TrevorFryman/BAE305-SP26-SemesterProject/Gear for servo Drawing v2.pdf

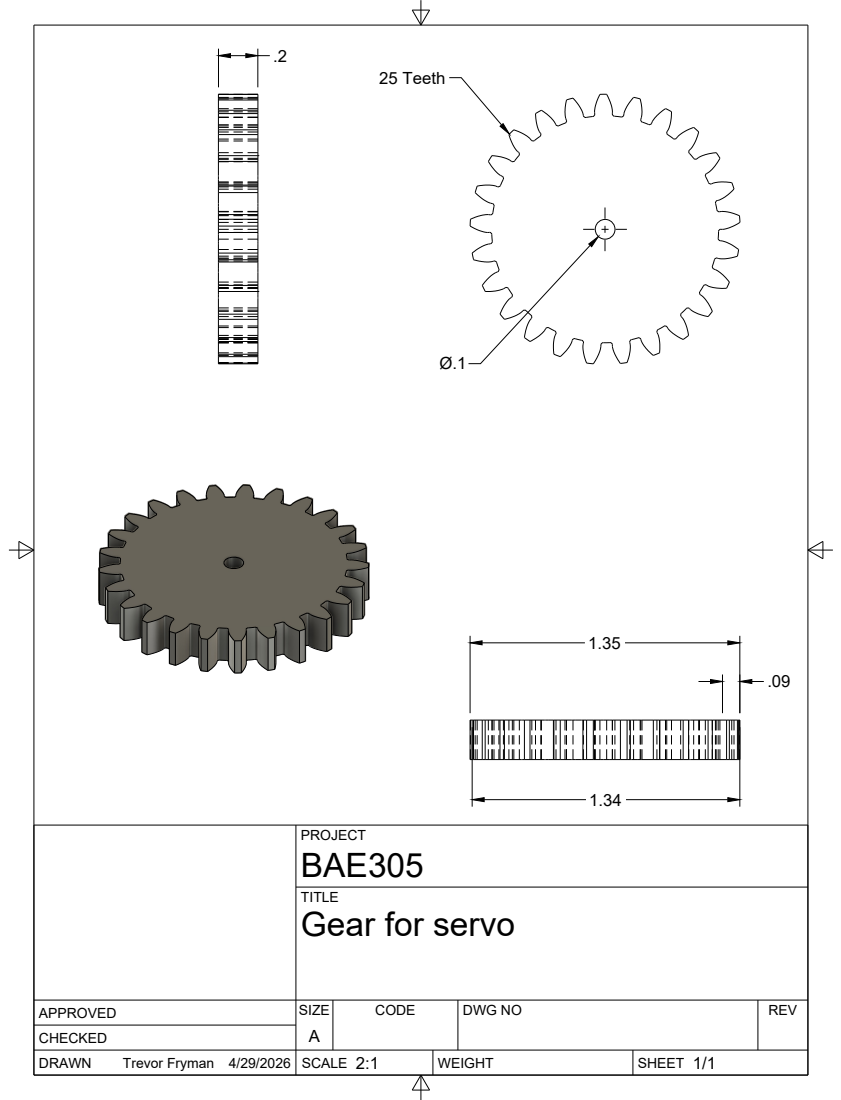
[picture p1: page 1]
SIZE; CODE; DWG NO; REV; Trevor Fryman 4/29/2026; Gear for servo; 25 Teeth
