TrevorFryman/BAE305-SP26-SemesterProject/Gear for temp knob Drawing v2.pdf

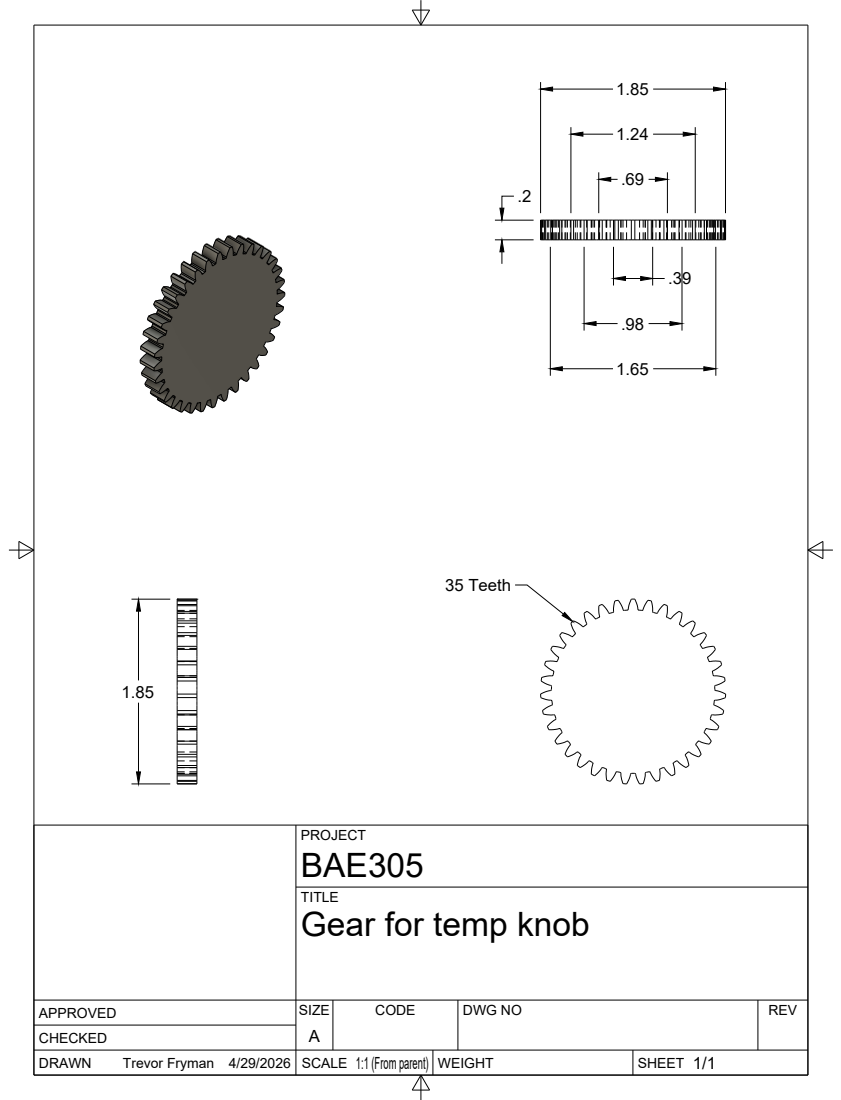
[picture p2: page 1]
SIZE; CODE; DWG NO; REV; Trevor Fryman 4/29/2026; 1:1 (From parent); 35 Teeth

PROJECT
BAE305
Gear for temp knob
