TrevorFryman/BAE305-SP26-SemesterProject/Knob for Potentiometer Drawing v1.pdf

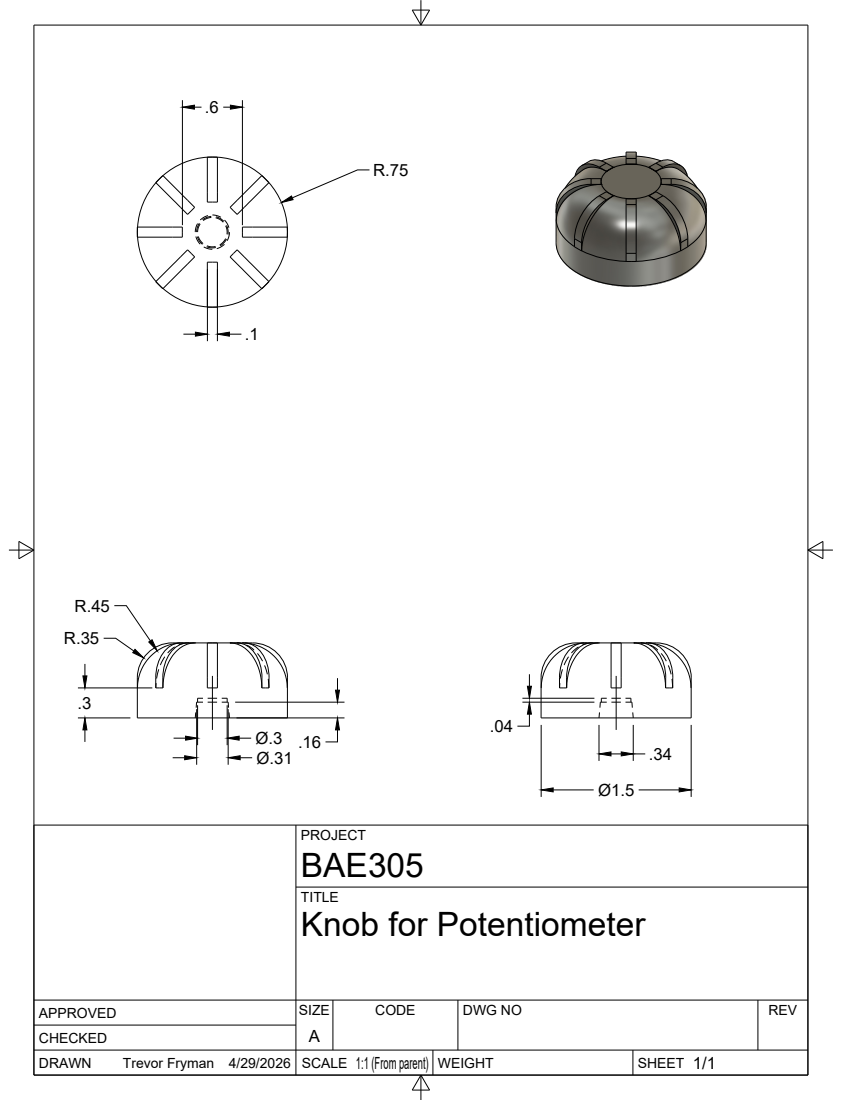
[picture p3: page 1]
SIZE; CODE; DWG NO; REV; Trevor Fryman 4/29/2026; 1:1 (From parent); Knob for Potentiometer
