TrevorFryman/BAE305-SP26-SemesterProject/(commit log)

2026-03-12 Add timer code to control LED with relay
2026-04-15 code
    This code integrates an ultrasonic sensor with a servo and a timer control for a cooking appliance. It includes safety features such as a timer cutoff and a manual reset mechanism.
2026-04-16 Code for individual Ultrasonic Sensor
2026-04-16 Schematic
    Added image and caption for circuit schematic.
2026-04-21 Integrate timer and sensor control code into README
    Added complete integrated code for timer, servo control, and ultrasonic sensor detection.
2026-04-27 Fix wiring diagram caption formatting
    Corrected the formatting of the wiring diagram caption in the README.
2026-04-29 Restore and update Test Results Discussion section
    Restored the 'Test Results Discussion' section and updated timer settings for clarity.
2026-04-30 Enhance README with detailed component descriptions
    Added descriptions of gears, knobs, and stand for clarity.
